akashihi/P11/docs/bom.csv

Reference | Qty | Value | Description | Footprint | Datasheet
U1 | 1 | ESP32-C3 Super Mini | ESP32-C3 development board, USB-C | ESP32-C3-SuperMini:ESP32-C3-SuperMini
Q3,Q4 | 2 | AO3400A | 30V 5.7A N-channel MOSFET (level shifter) | Package_TO_SOT_SMD:SOT-23 | http://www.aosmd.com/pdfs/datasheet/AO3400A.pdf
D1 | 1 | US1A | 50V 1A fast rectifier, reverse-polarity protection on 5V | Diode_SMD:D_SMA | https://www.diodes.com/assets/Datasheets/ds16008.pdf
C1 | 1 | 470uF | Polarized electrolytic capacitor, >=10V, 8x10.5 mm SMD | Capacitor_SMD:CP_Elec_8x10.5
R1,R2,R3,R4 | 4 | 10k | Resistor 0805 (level shifter pull-ups) | Resistor_SMD:R_0805_2012Metric
R5 | 1 | 4k7 | Resistor 0805 (1-Wire pull-up) | Resistor_SMD:R_0805_2012Metric
U2 | 1 | DS18B20 | 1-Wire digital thermometer, TO-92 (optional) | Package_TO_SOT_THT:TO-92_Inline | http://datasheets.maximintegrated.com/en/ds/DS18B20.pdf
J1 | 1 | 1x05 pin header | 2.54 mm pin header, 5 pins (CN-CNT cable) | Connector_PinHeader_2.54mm:PinHeader_1x05_P2.54mm_Vertical
