akashihi/P11/docs/schematic.pdf

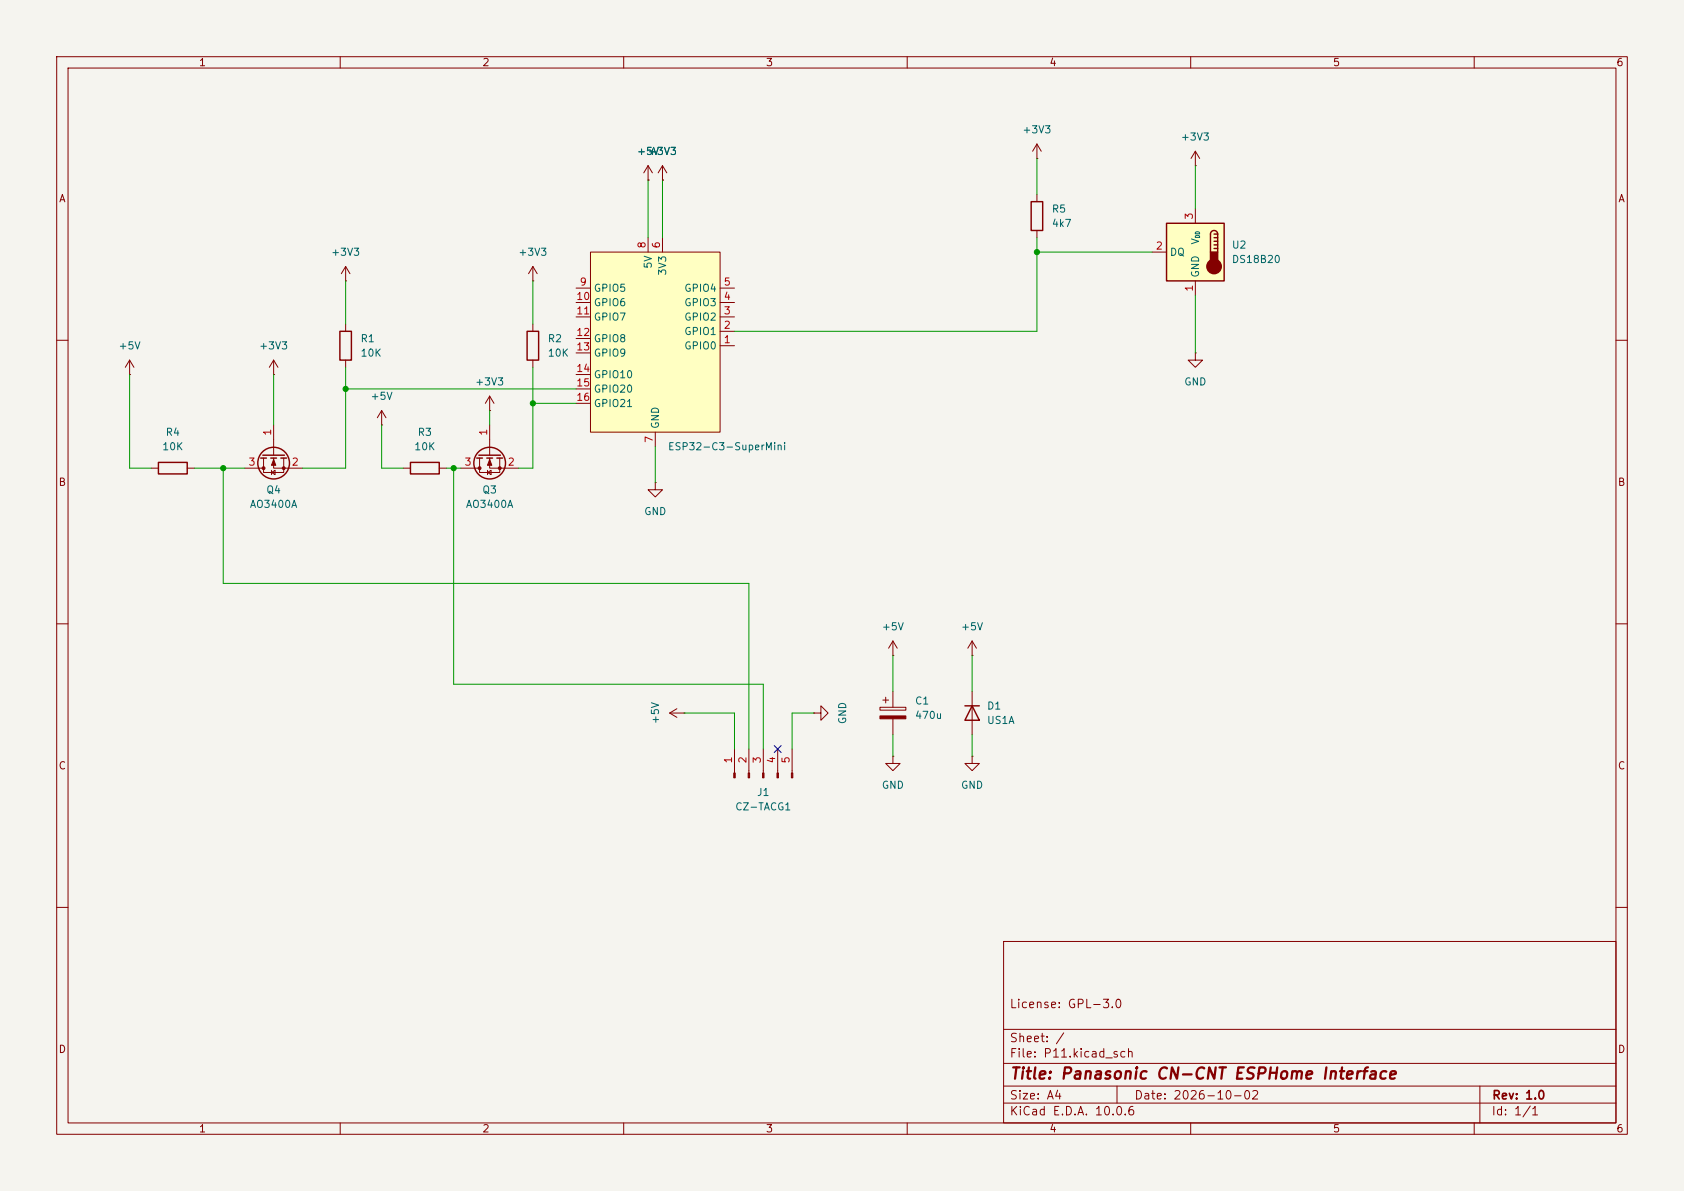
[picture p3: page 1]

Sheet: /
File: P11.kicad_sch
Title: Panasonic CN-CNT ESPHome Interface

Size: A4 | Rev: 1.0
KiCad E.D.A. 10.0.6 | Id: 1/1
