akashihi/P11/P11/P11.kicad_pcb

## KiCad design P11/P11.kicad_pcb (2026-10-02)

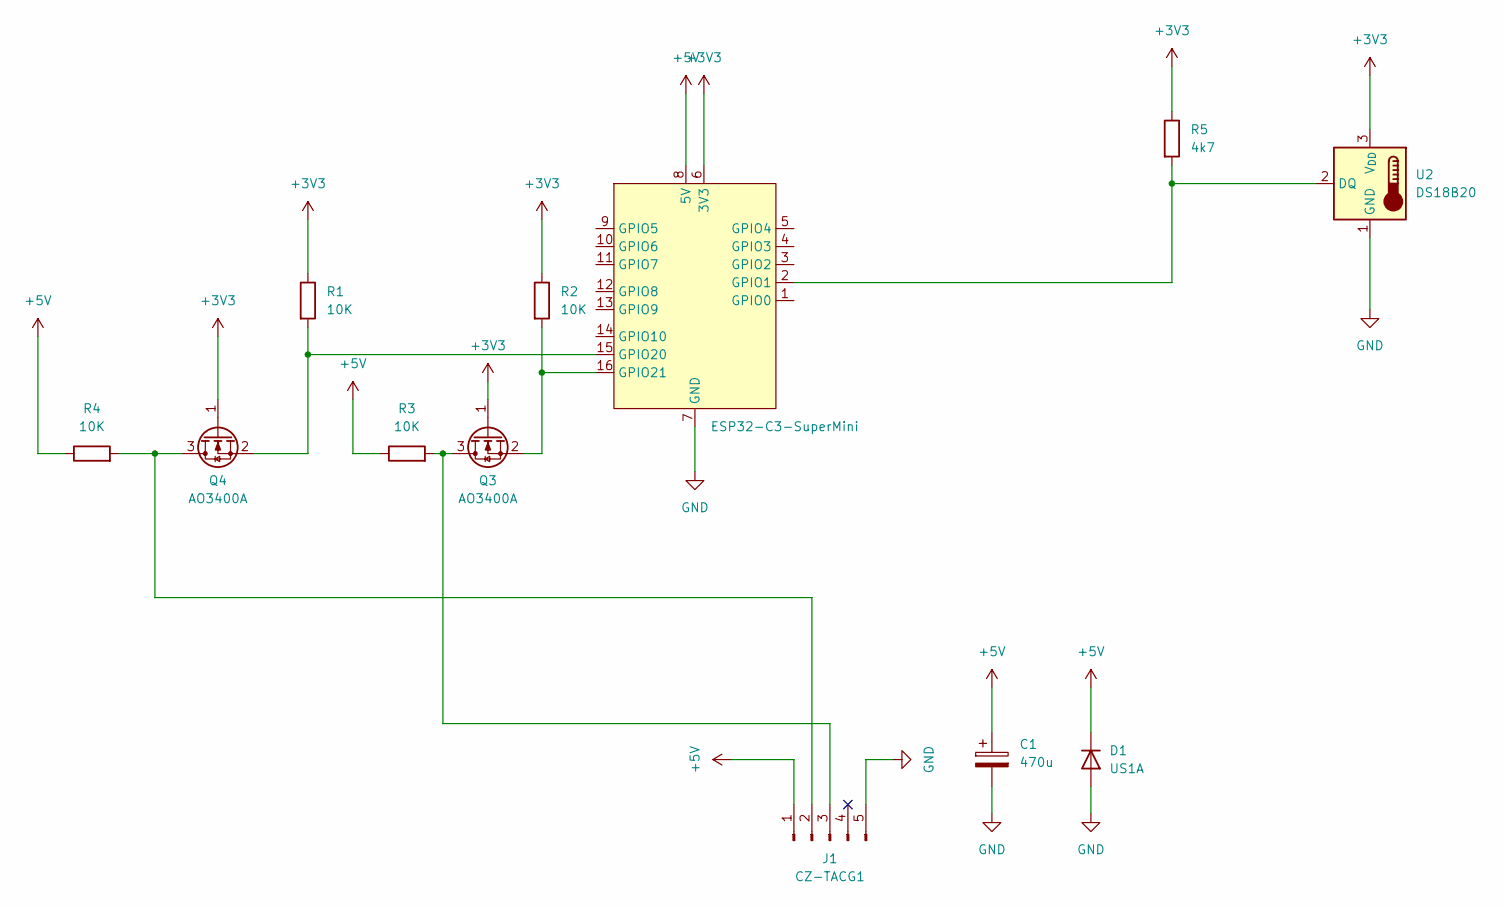
[picture p4: schematic P11.kicad_sch, Panasonic CN-CNT ESPHome Interface]

Parts:
C1: 470u; CP_Elec_8x10.5
D1: US1A; D_SMA
J1: CZ-TACG1; PinHeader_1x05_P2.54mm_Vertical
Q3, Q4: AO3400A; SOT-23
R1, R2, R3, R4: 10K; R_0805_2012Metric
R5: 4k7; R_0805_2012Metric
U1: ESP32-C3-SuperMini
U2: DS18B20; TO-92_Inline

Connections:
+3V3: Q3.1 (G), Q4.1 (G), R1.1, R2.1, R5.1, U1.6 (3V3), U2.3 (V_{DD})
+5V: C1.1, D1.1 (K), J1.1, R3.1, R4.1, U1.8 (5V)
GND: C1.2, D1.2 (A), J1.5, U1.7 (GND), U2.1 (GND)
unnamed: J1.2, Q4.3 (D), R4.2
unnamed: J1.3, Q3.3 (D), R3.2
unnamed: Q3.2 (S), R2.2, U1.16 (GPIO21)
unnamed: Q4.2 (S), R1.2, U1.15 (GPIO20)
unnamed: R5.2, U1.2 (GPIO1), U2.2 (DQ)

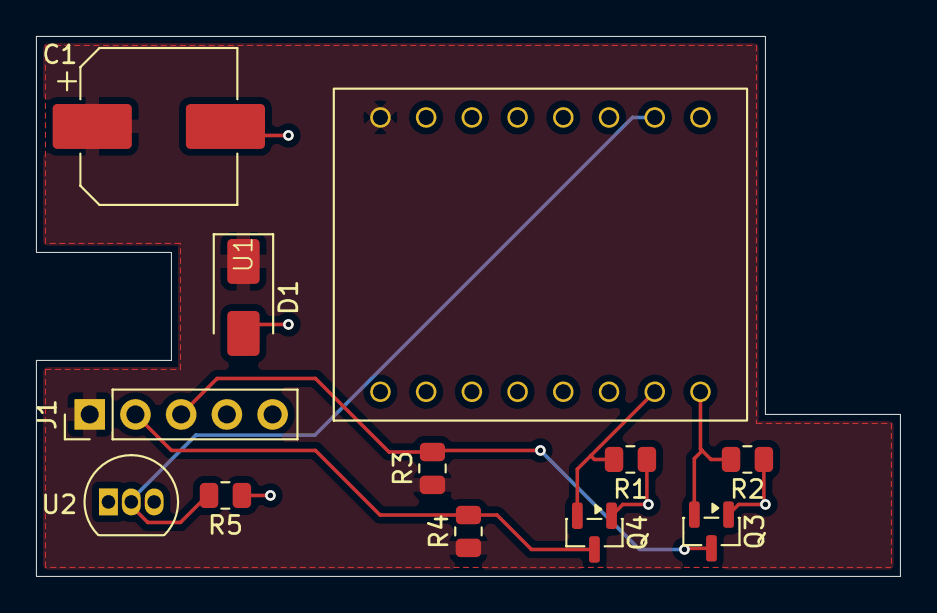
[picture p5: board P11.kicad_pcb from above]

Board: 4 copper layers, 48.0 x 30.0 mm, 12 parts (0 on the bottom side), 8 nets.
