akashihi/P11/(notices)

Notices in the files:
P11/P11.kicad_pcb:
License: GPL-3.0
